LonghornSilicon/lambda/chip/README.md

# chip/ — cross-block integration (belongs to no single block)

Cross-block work that isn't owned by any one block: the integration cosim and the full-chip PDK
assembly. Mirrors (optionally) to `lambda-chip`.

```
chip/
├── verif/       Cross-block cosim: tb_chip_cosim.sv + vendored block RTL (blocks/) + Makefile + real-Qwen vectors.
│               Run: make -C chip/verif cosim
└── pdk/gf180/   Full-chip GF180MCU padring assembly (imported from the former chipathon-lambda-acu; honest skeleton).
```

## verif/ — the cross-block cosim
First cross-block integration of the live block RTLs on one shared attention tile, with a real INT8
P·V MAC so the attention output flows all the way through. Curated copy of the former `architecture`
repo's cross-block cosim (now sourced here). See `verif/README.md` for what runs.

**Note (drift):** `verif/blocks/` currently **vendors copies** of the KVE/ACU/TIU block RTL (the
copy-drift the monorepo is meant to eliminate). Once `src/blocks/kve/rtl`, `src/blocks/tiu/rtl`, and `acu/rtl` are the
single source of truth, re-point the `verif/Makefile` include paths at them and drop the vendored
copies. ACU is now imported (`acu/{mate,vecu,precision_controller}/rtl` exist as canonical RTL), so
this re-point is **unblocked** — pending, not held.
