LonghornSilicon/lambda/src/blocks/tiu/docs/findings/h2o-analysis.md

# H2O Accumulated-Mass Token Retention on Qwen2 — Analysis Phase

**Status:** Complete — algorithm validated, proceed to RTL.
**Date:** 2026-07-17.
**One-line:** H2O (keep recent window + top heavy-hitters by accumulated post-softmax
attention mass) holds HellaSwag acc_norm within −0.006 of a full KV cache down to a
25% cache budget on Qwen2-0.5B; it degrades sharply below ~15%.

---

## Motivation

Block 3 (Token Importance Unit) must keep the KV cache within a fixed on-die budget
as context grows. That requires a per-token importance signal and an eviction policy.
The ACU sparsity study already settled the *signal*: **post-softmax attention mass
predicts token importance (r≈0.99); pre-softmax proxies do not (r≈0)**. H2O is the
canonical policy built on that signal, and is what we're carrying into silicon.

## Method

`analysis/h2o_analysis.py` registers a custom Qwen2 attention (transformers 5.x
`AttentionInterface`) that, per (layer, head):

1. Computes the causal post-softmax attention matrix `A` (scores in fp32 — fp16
   QK^T over D=128 overflows to NaN).
2. Accumulates each key's received mass `acc[i,j] = Σ_{q≤i} A[q,j]` (`A.cumsum`).
3. For a fixed cache budget of C tokens (fraction of sequence length), once the
   sequence exceeds C, retains a recent window of L = C/2 tokens plus the top
   (C − L) heavy hitters by `acc`, and masks out the rest, renormalizing `A`.

Evaluated on HellaSwag (n=500) across budget fractions 1.0 → 0.10.
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
