LonghornSilicon/lambda/research/apa-precision-policy/analysis/figures/accuracy_vs_baselines.png

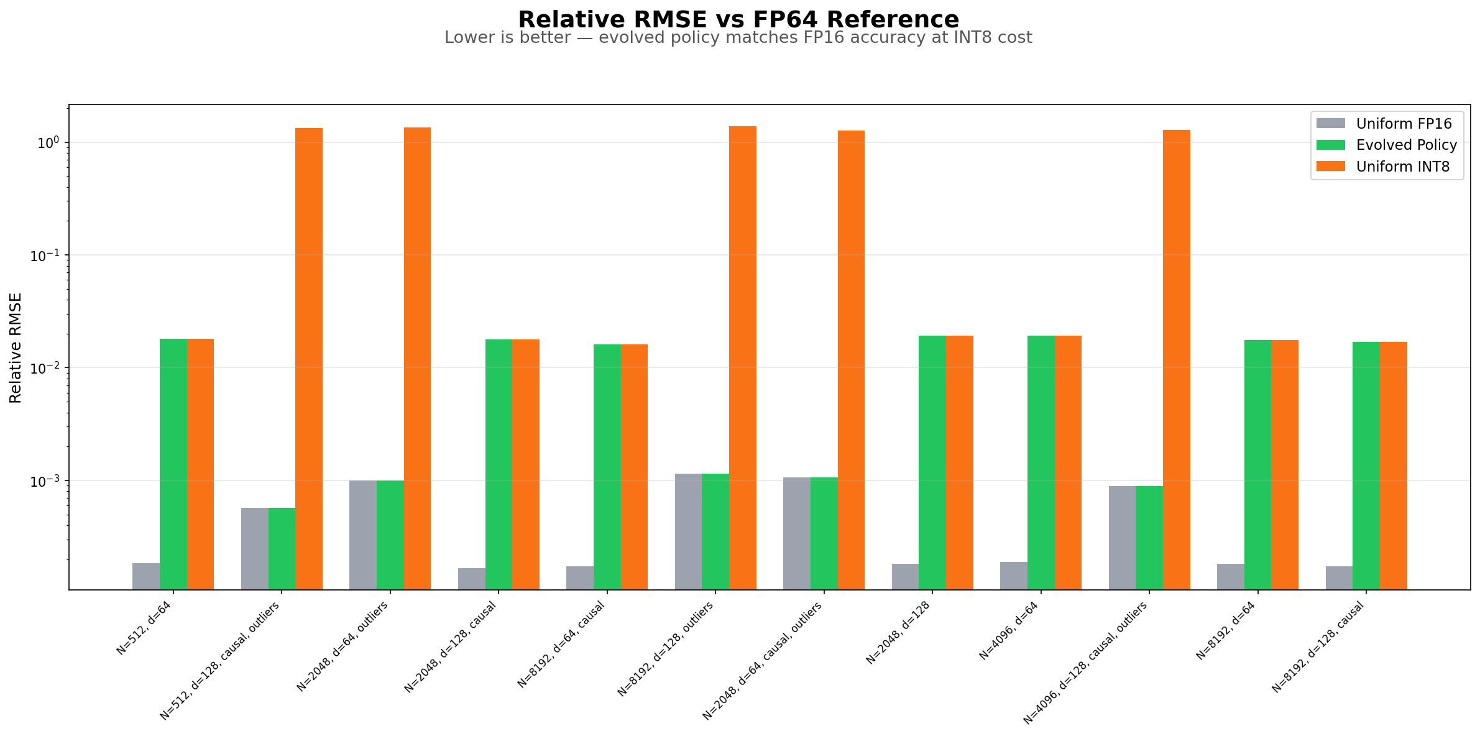
research/apa-precision-policy/analysis/figures/accuracy_vs_baselines.png
