LonghornSilicon/lambda/research/apa-precision-policy/analysis/figures/block_size_sweep.png

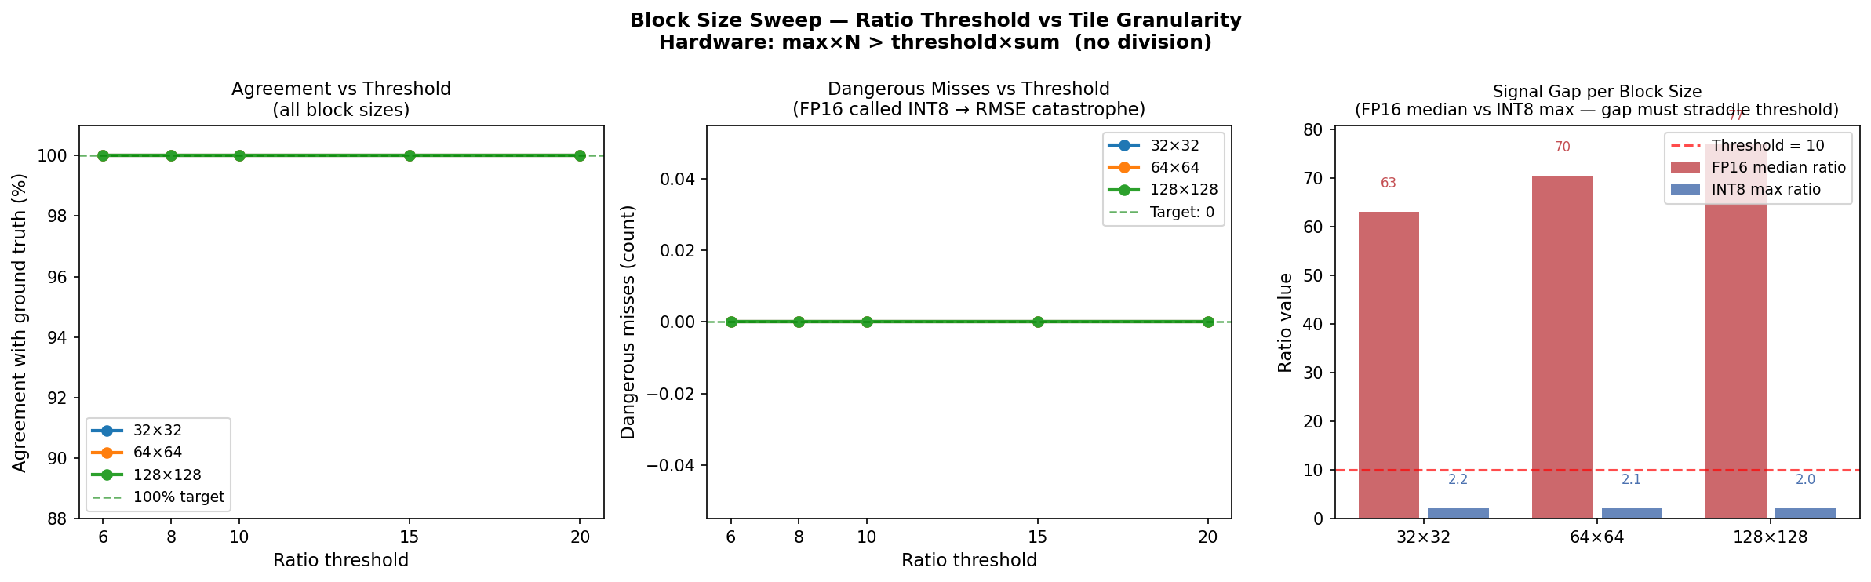
research/apa-precision-policy/analysis/figures/block_size_sweep.png
