LonghornSilicon/lambda/research/apa-precision-policy/analysis/figures/compression_summary.png

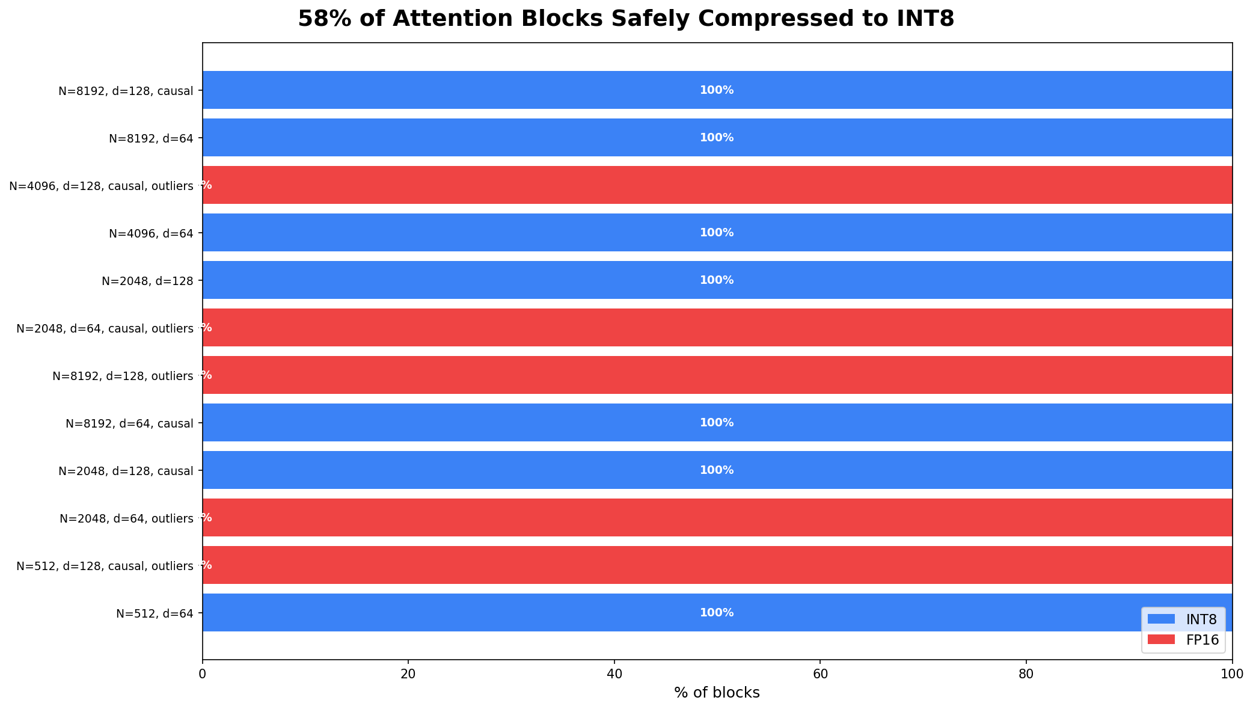
research/apa-precision-policy/analysis/figures/compression_summary.png
