LonghornSilicon/lambda/research/apa-precision-policy/analysis/figures/deep_layer_comparison.png

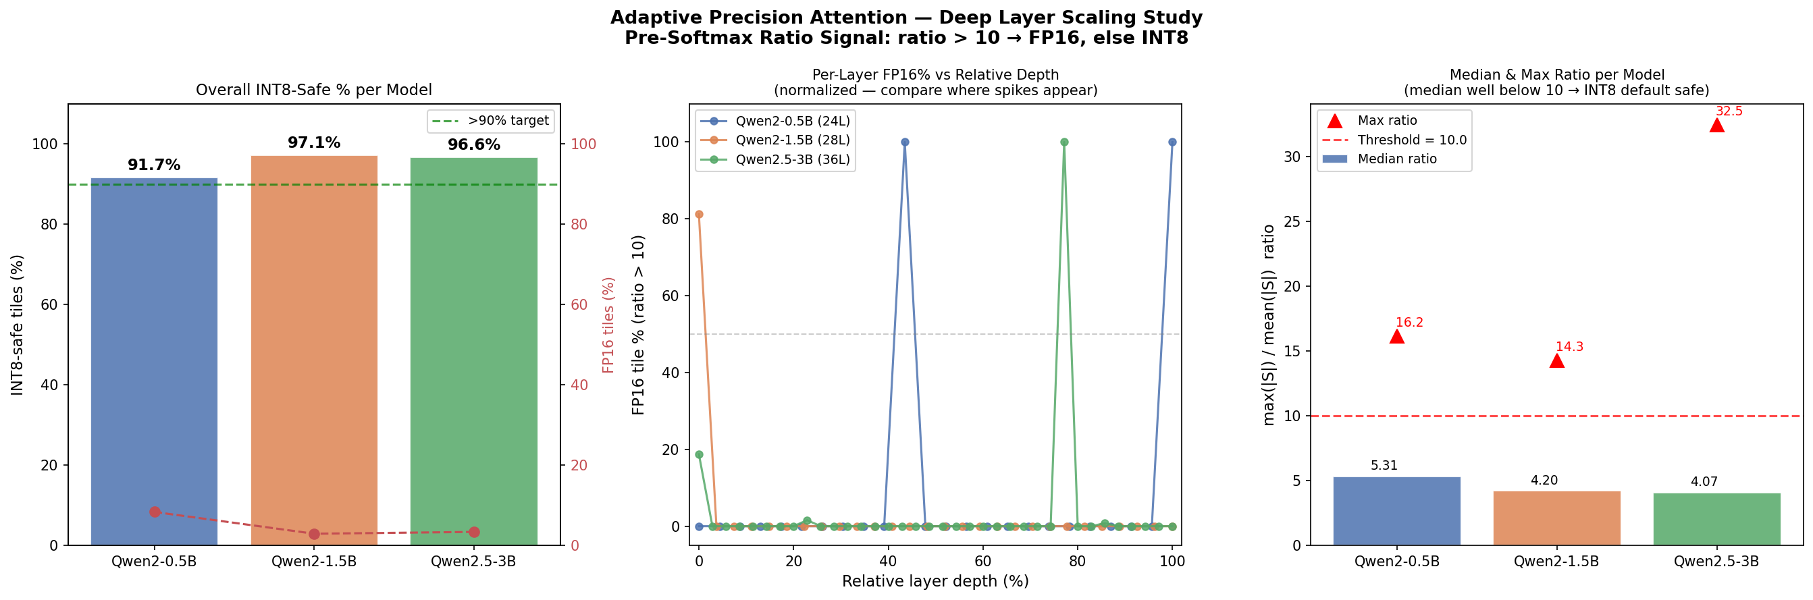
research/apa-precision-policy/analysis/figures/deep_layer_comparison.png
