LonghornSilicon/lambda/research/apa-precision-policy/analysis/figures/entropy_distribution.png

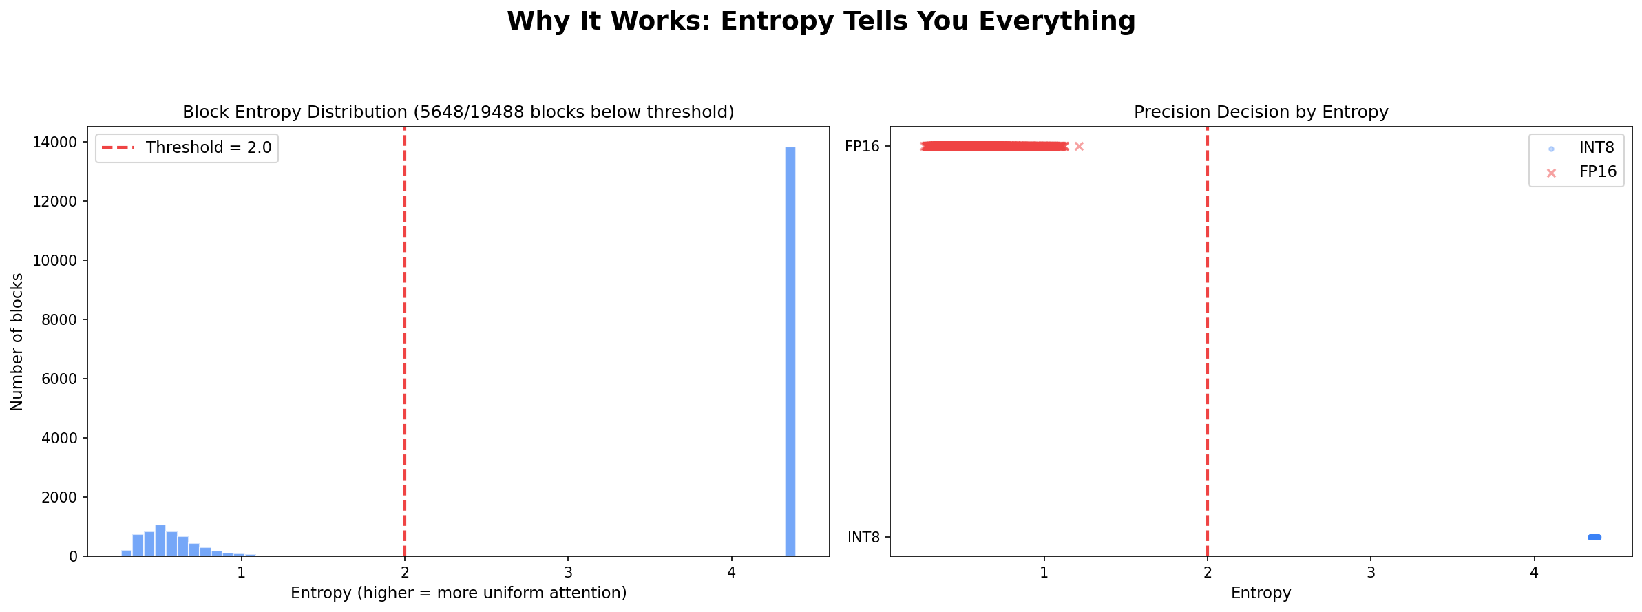
research/apa-precision-policy/analysis/figures/entropy_distribution.png
