LonghornSilicon/lambda/research/apa-precision-policy/analysis/figures/fixed_point_sim.png

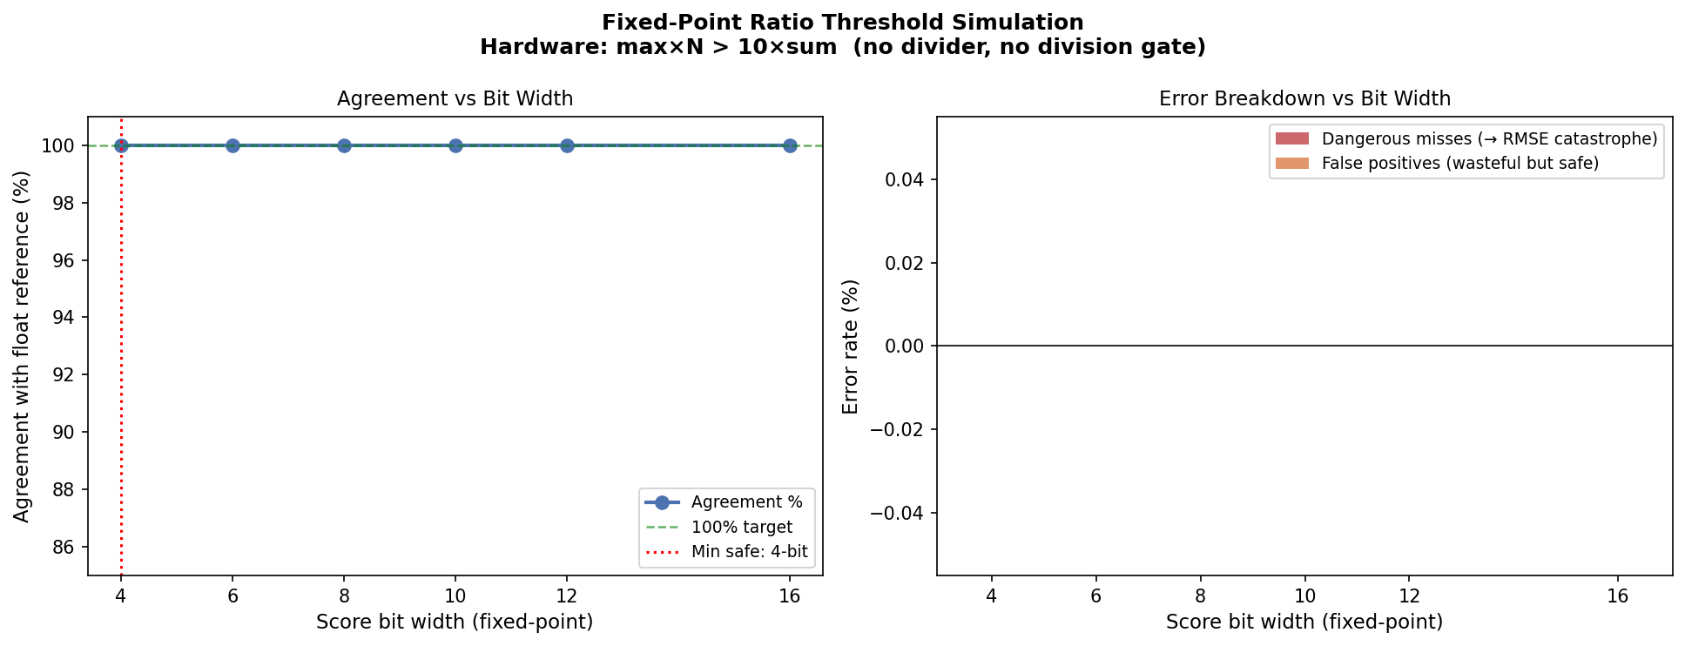
research/apa-precision-policy/analysis/figures/fixed_point_sim.png
