LonghornSilicon/lambda/research/apa-precision-policy/analysis/figures/precision_heatmaps.png

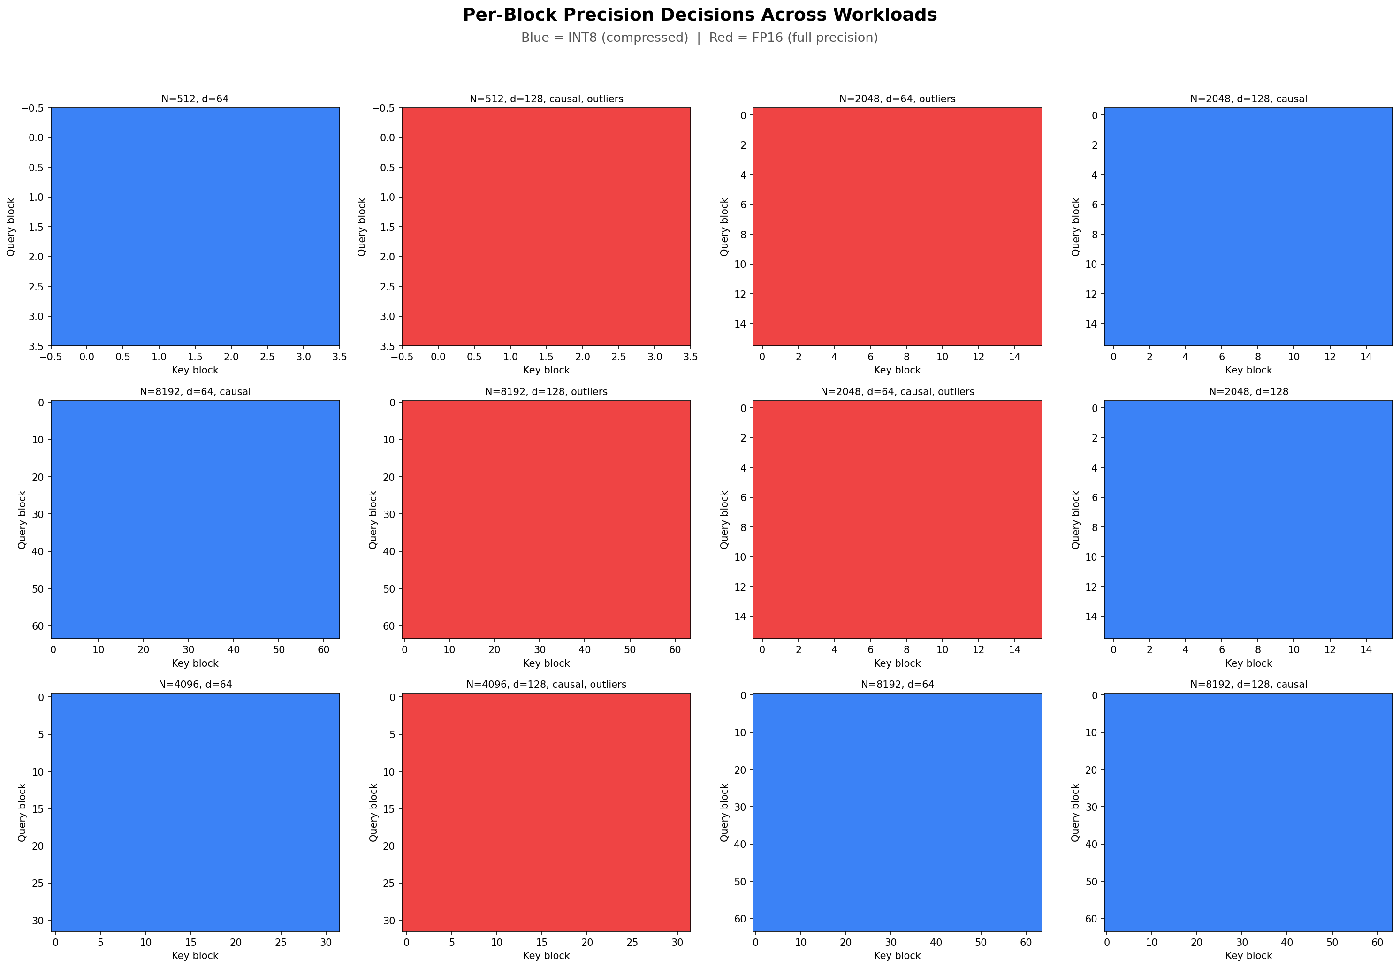
research/apa-precision-policy/analysis/figures/precision_heatmaps.png
