LonghornSilicon/lambda/research/apa-precision-policy/analysis/figures/real_llm_v2.png

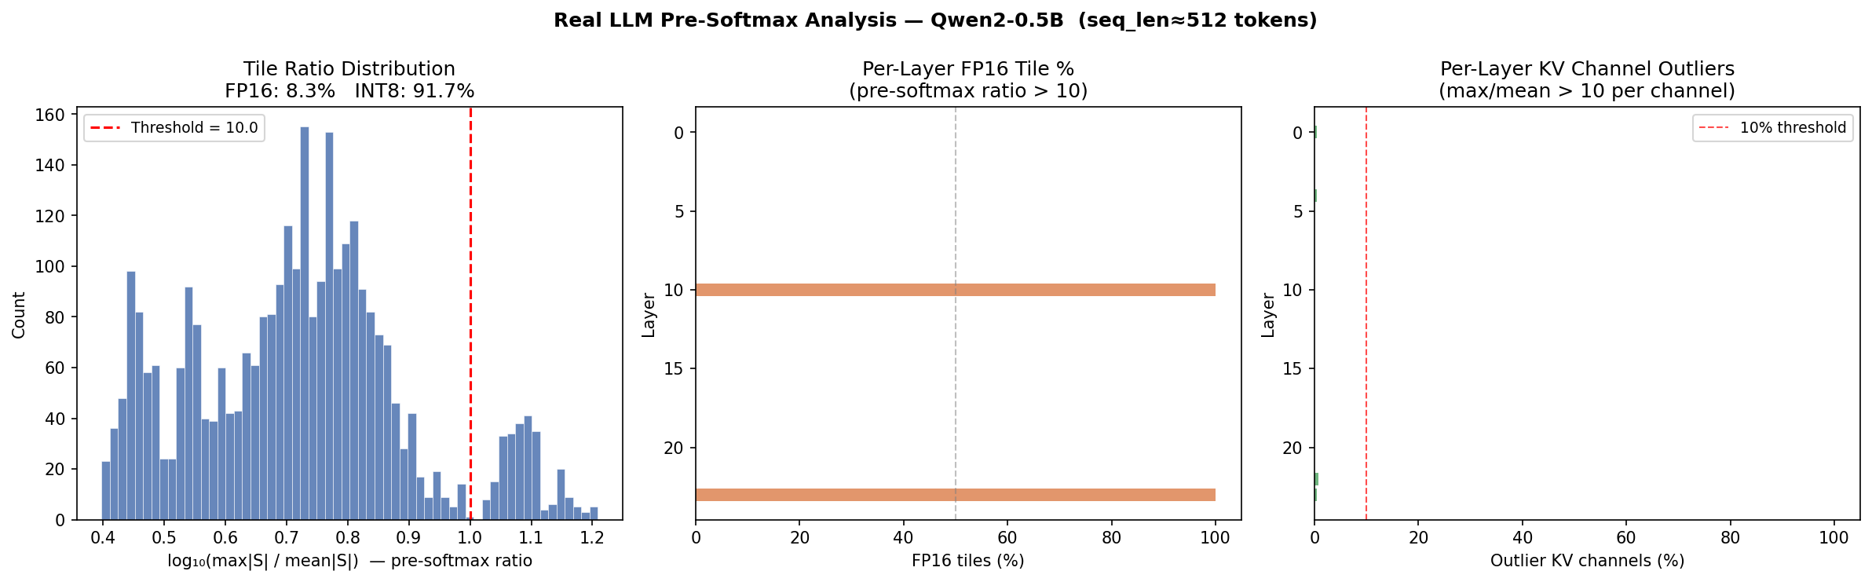
research/apa-precision-policy/analysis/figures/real_llm_v2.png
