LonghornSilicon/lambda/research/apa-precision-policy/analysis/figures/rtl_area_vs_bitwidth.png

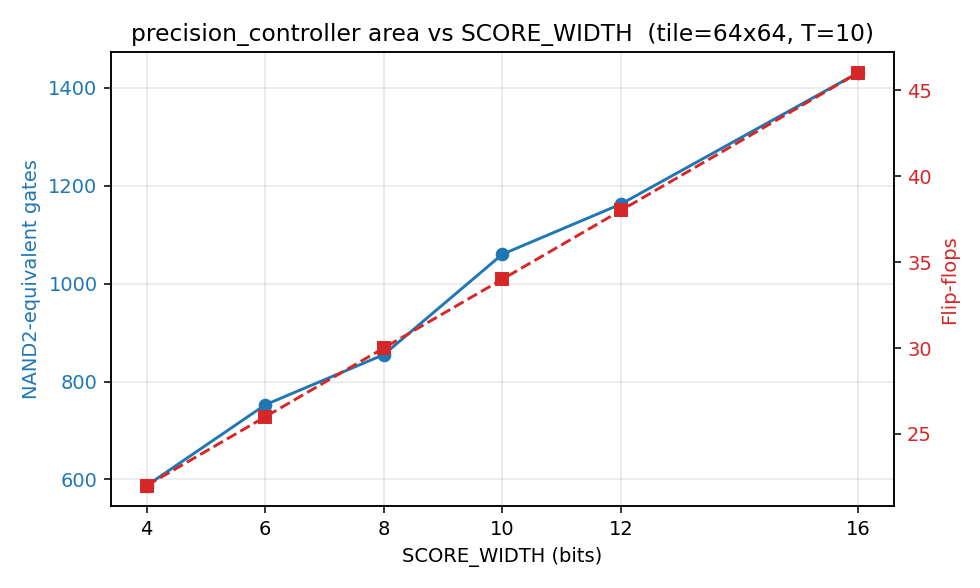
research/apa-precision-policy/analysis/figures/rtl_area_vs_bitwidth.png
