LonghornSilicon/lambda/research/apa-precision-policy/analysis/figures/seq_length_scaling.png

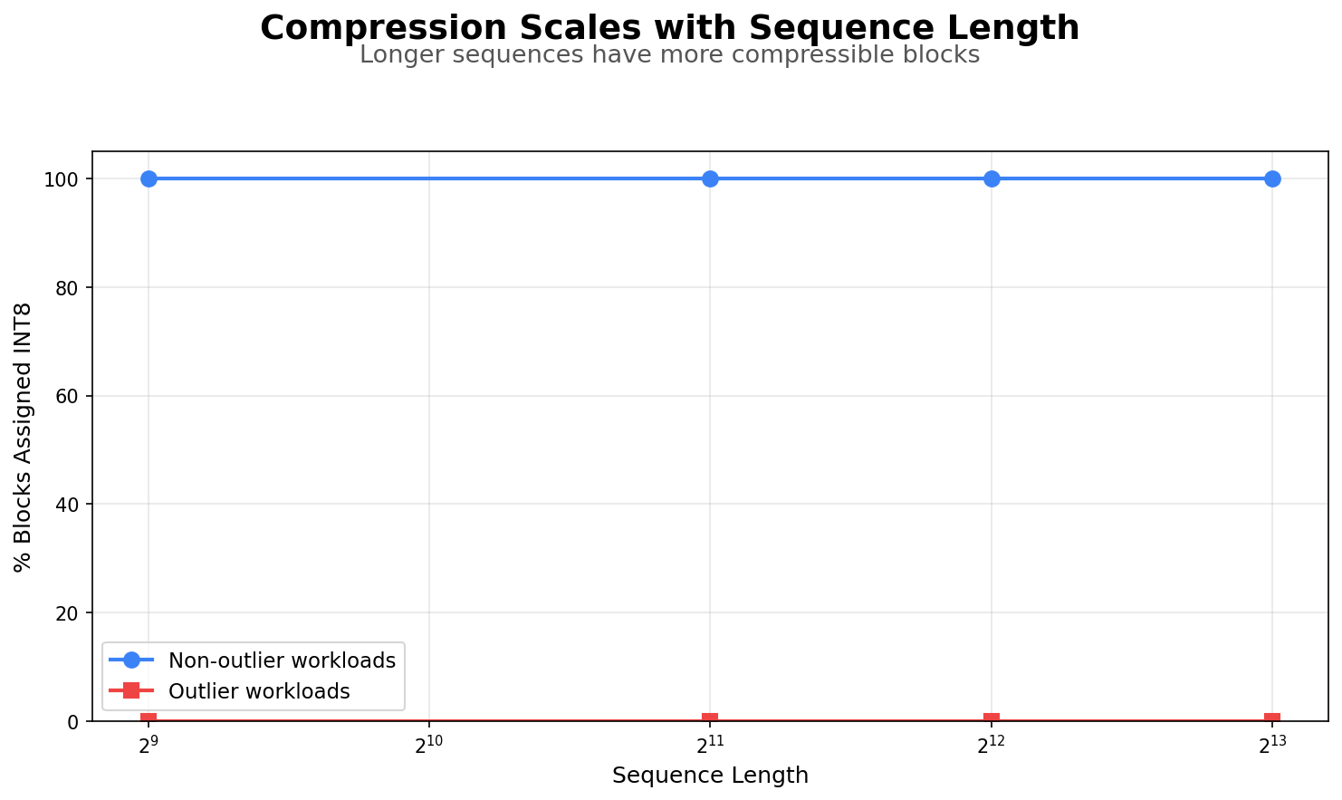
research/apa-precision-policy/analysis/figures/seq_length_scaling.png
