LonghornSilicon/lambda/research/apa-precision-policy/analysis/figures/phi2_validation.png

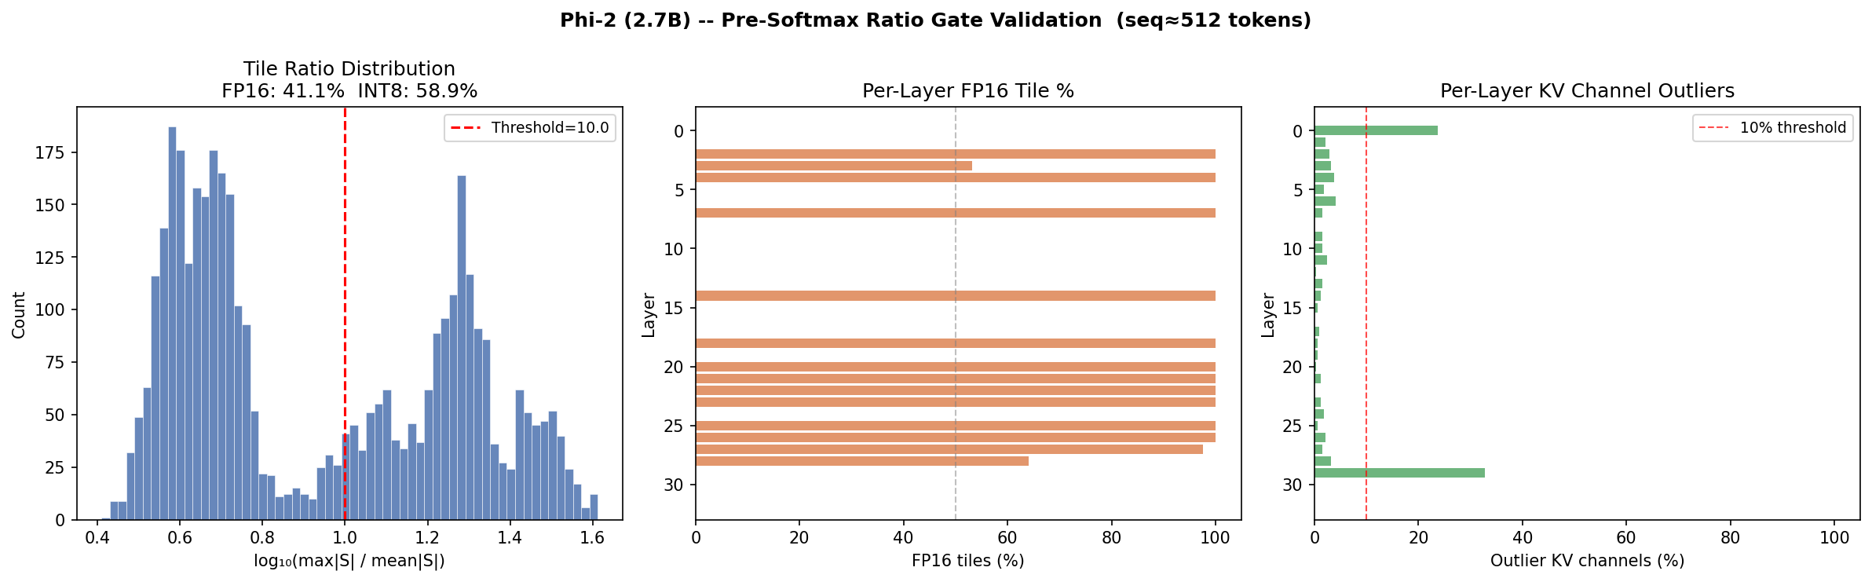
research/apa-precision-policy/analysis/figures/phi2_validation.png
