LonghornSilicon/lambda/research/apa-precision-policy/analysis/figures/real_llm_validation.png

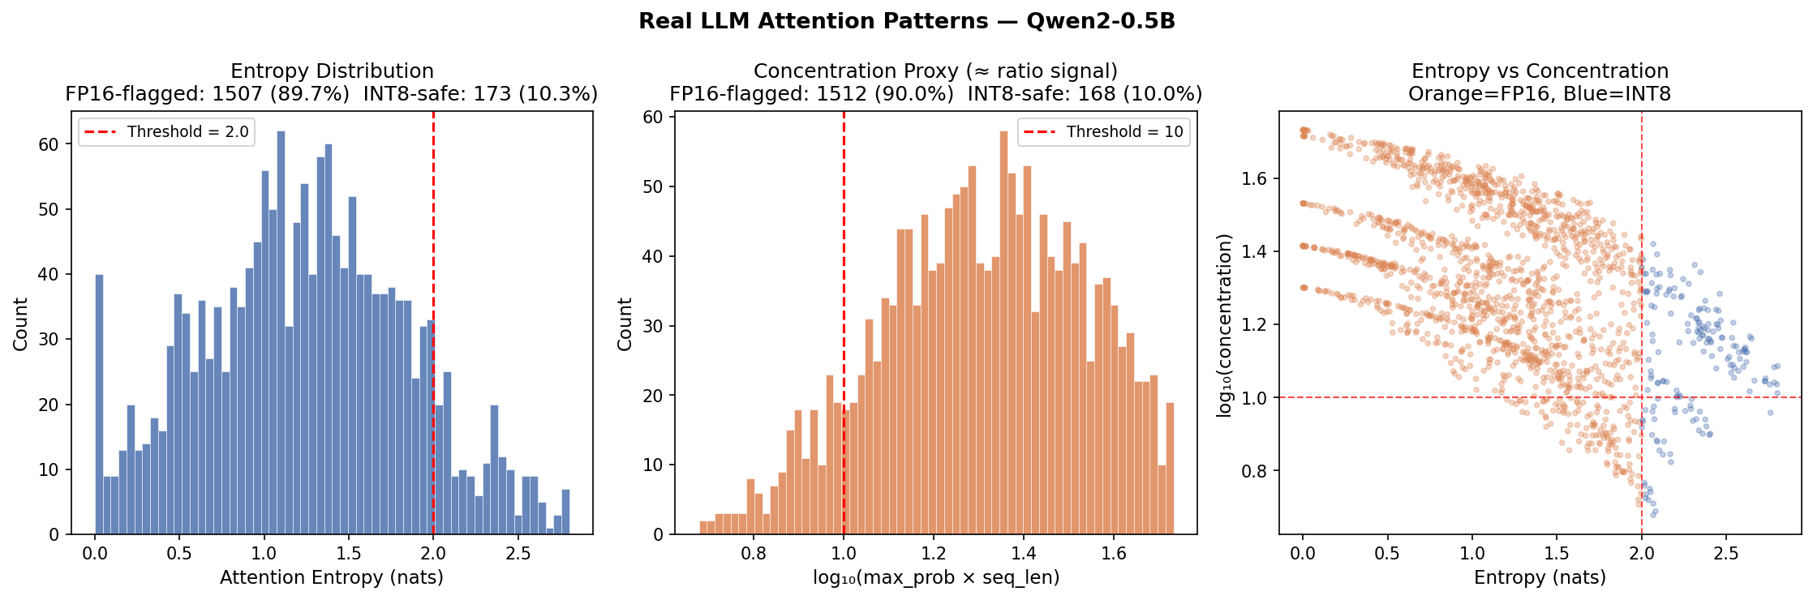
research/apa-precision-policy/analysis/figures/real_llm_validation.png
