LonghornSilicon/lambda/src/blocks/acu/mate/pdk/asap7/orfs/asap7/mate_pv_fp16/results_asap7/mate_pv_fp16_asap7_layout.webp

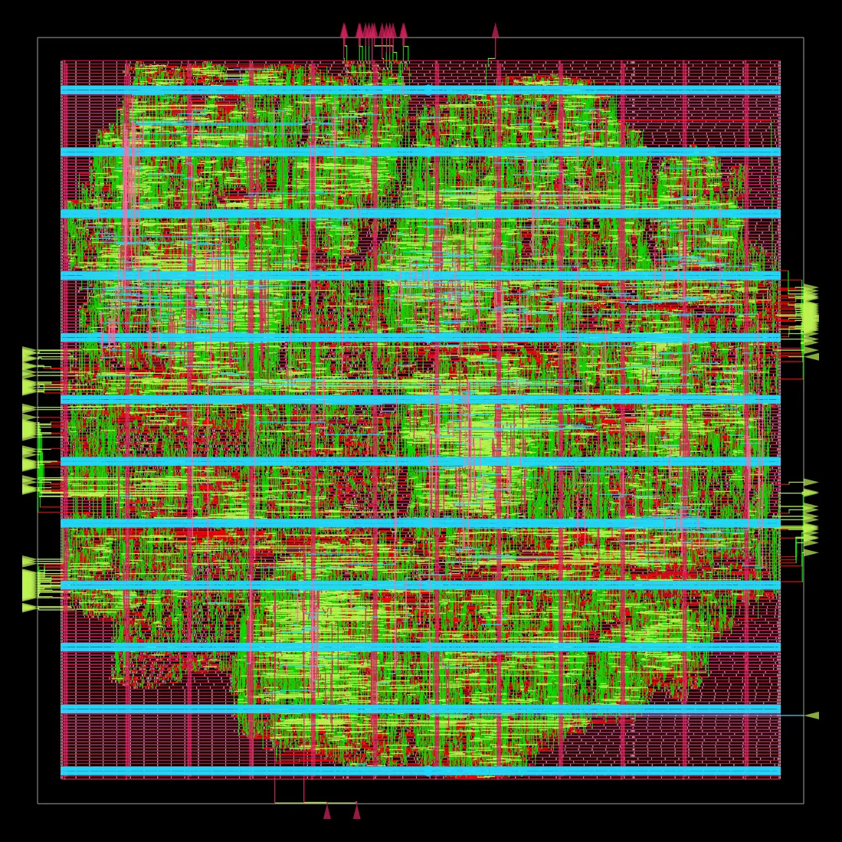
src/blocks/acu/mate/pdk/asap7/orfs/asap7/mate_pv_fp16/results_asap7/mate_pv_fp16_asap7_layout.webp
