LonghornSilicon/lambda/src/blocks/acu/mate/pdk/sky130/openlane/mate_pv/results/mate_pv.png

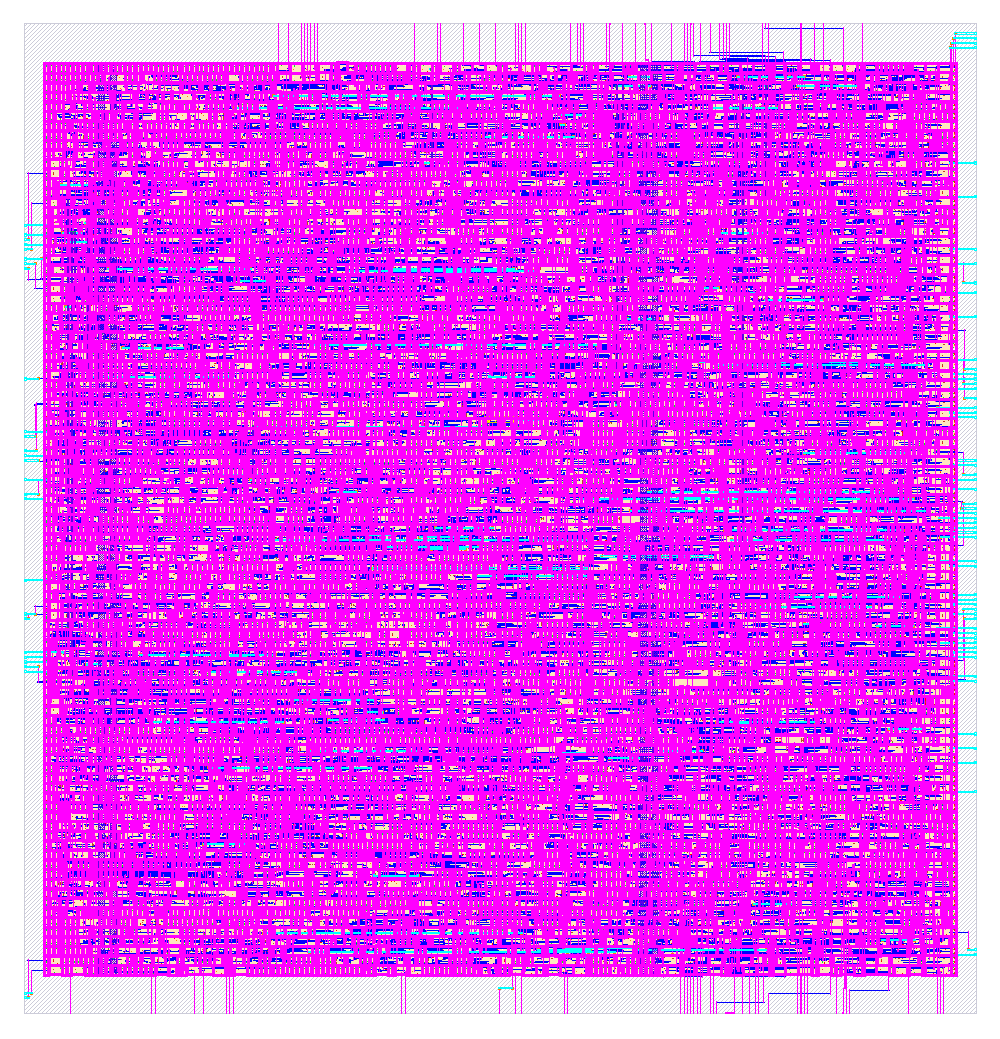
src/blocks/acu/mate/pdk/sky130/openlane/mate_pv/results/mate_pv.png
