LonghornSilicon/lambda/src/blocks/acu/mate/pdk/sky130/openlane/mate_pv_fp16/results/mate_pv_fp16.png

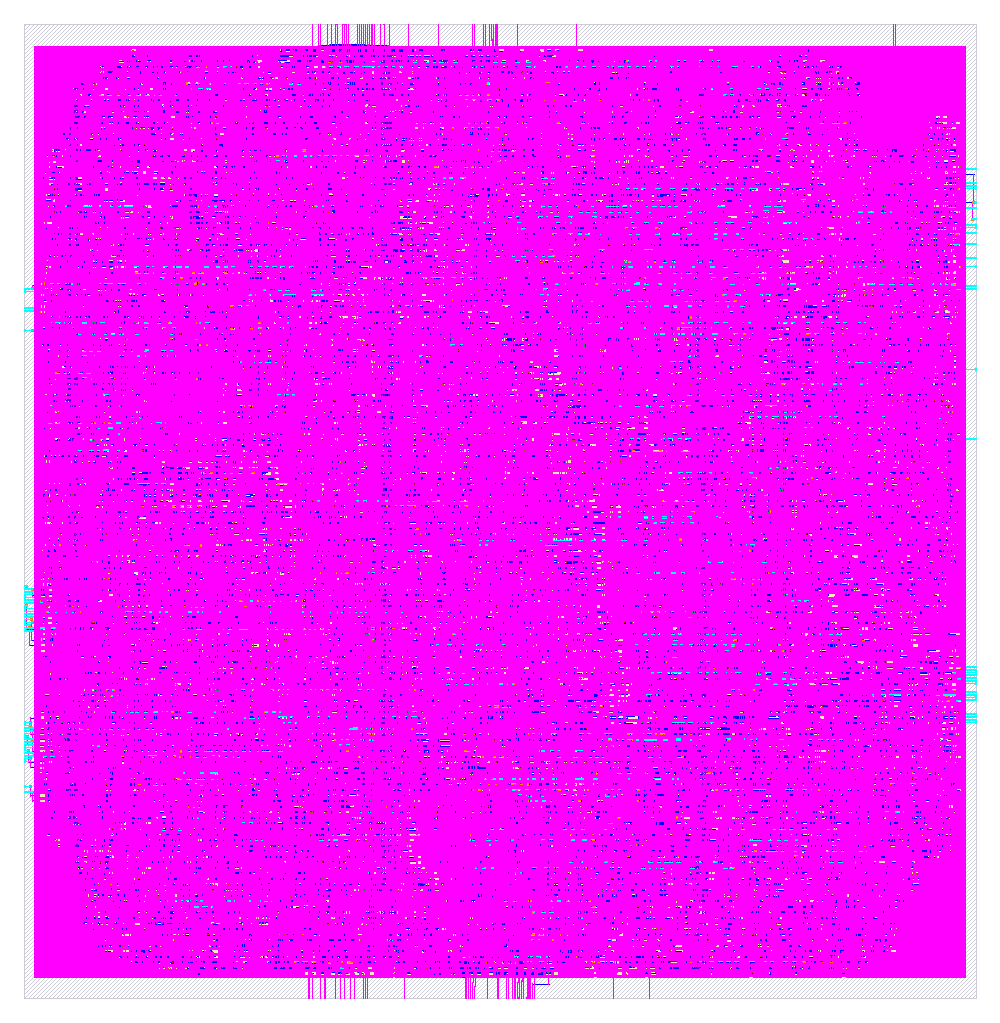
src/blocks/acu/mate/pdk/sky130/openlane/mate_pv_fp16/results/mate_pv_fp16.png
