LonghornSilicon/lambda/src/blocks/acu/mate/pdk/sky130/openlane/mate_qkt/results/mate_qkt.png

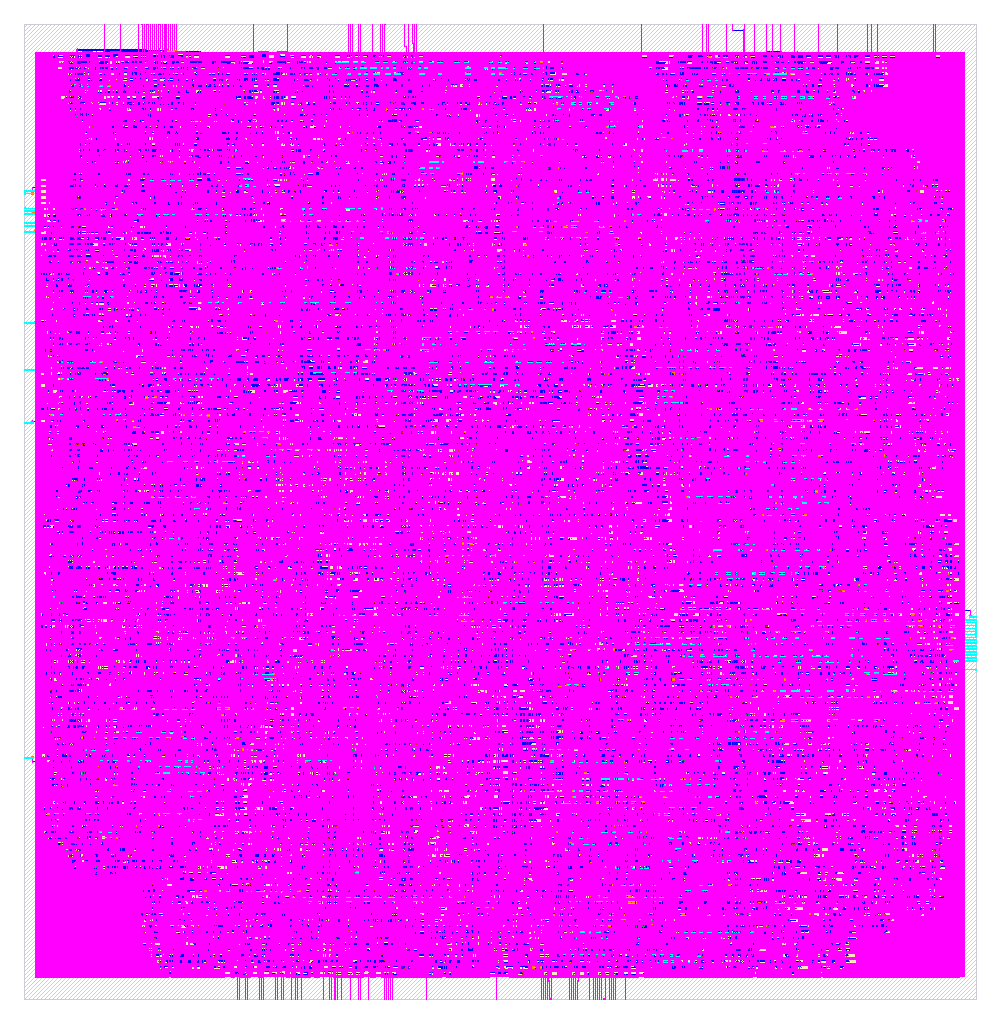
src/blocks/acu/mate/pdk/sky130/openlane/mate_qkt/results/mate_qkt.png
