LonghornSilicon/lambda/src/blocks/acu/precision_controller/pdk/asap7/orfs/asap7/precision_controller/results_asap7/precision_controller_asap7_layout.webp

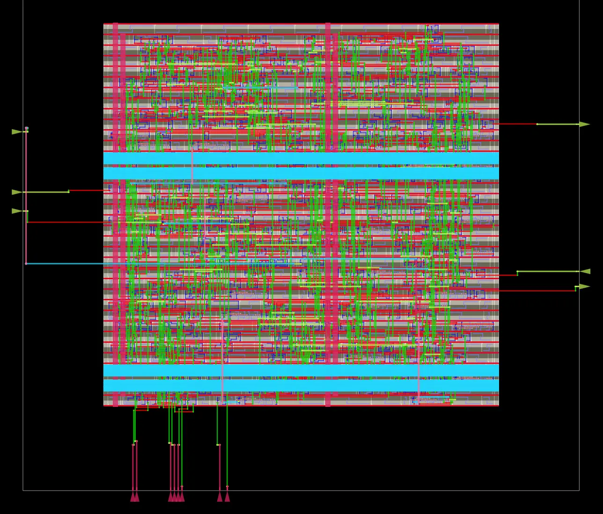
src/blocks/acu/precision_controller/pdk/asap7/orfs/asap7/precision_controller/results_asap7/precision_controller_asap7_layout.webp
