LonghornSilicon/lambda/src/blocks/acu/precision_controller/pdk/sky130/openlane/precision_controller/results/precision_controller.png

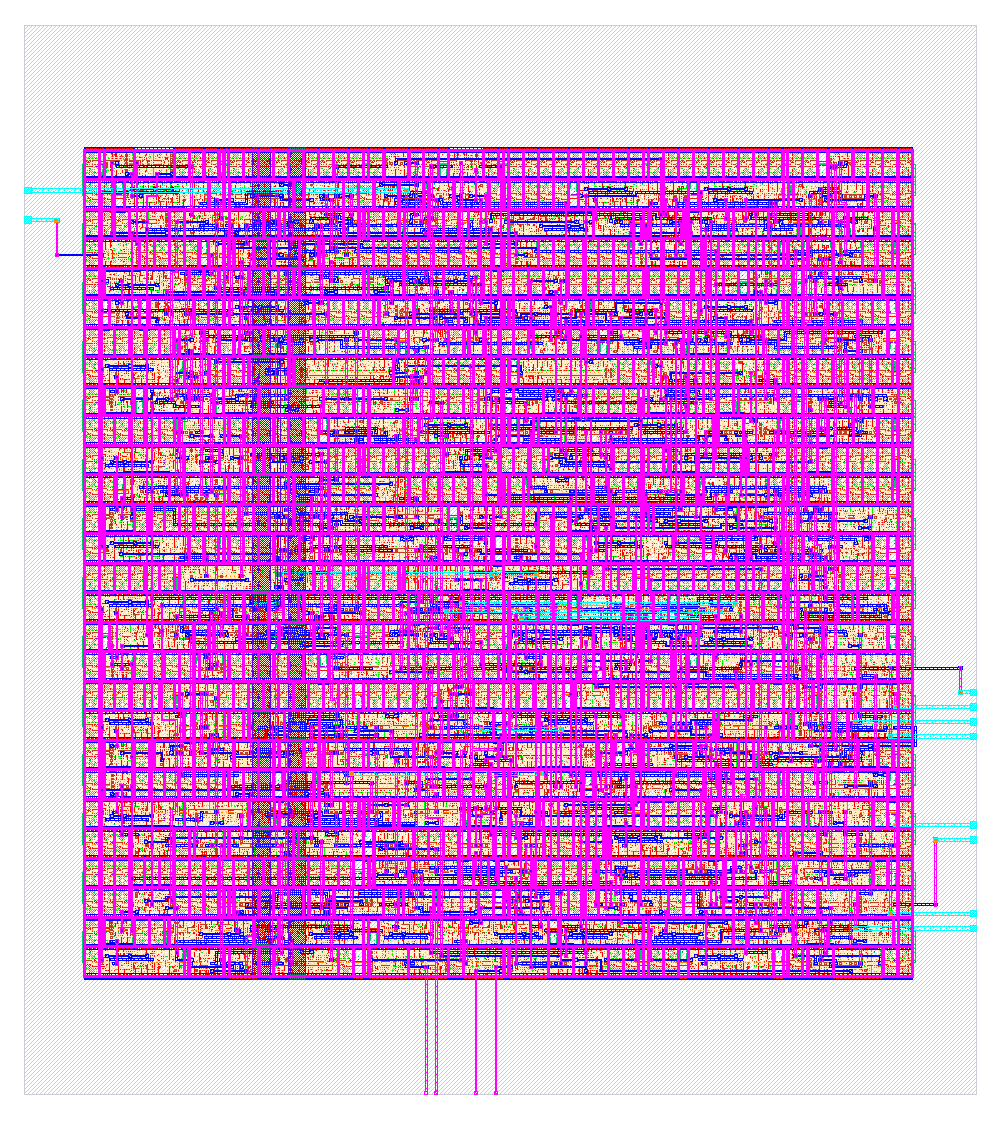
src/blocks/acu/precision_controller/pdk/sky130/openlane/precision_controller/results/precision_controller.png
