LonghornSilicon/lambda/src/blocks/acu/vecu/pdk/gf180/librelane/results/rmsnorm/rmsnorm_layout.png

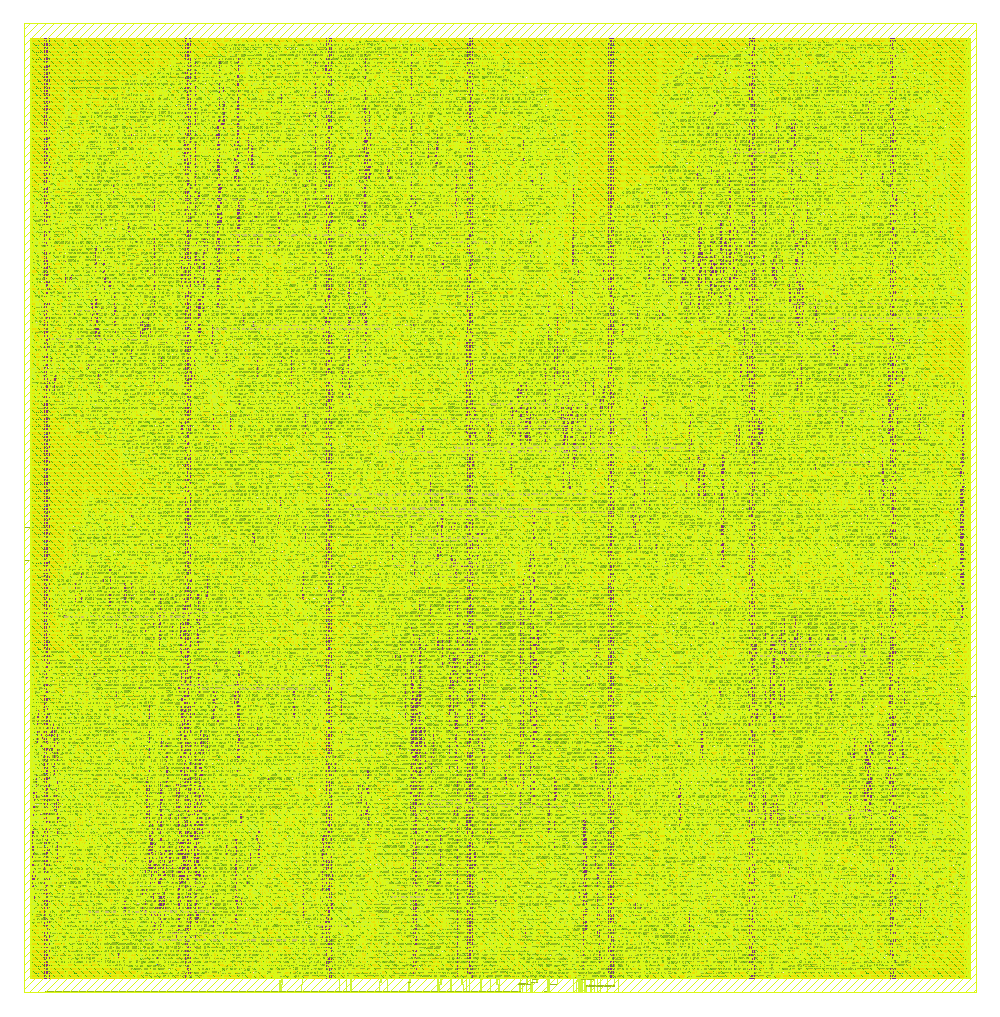
src/blocks/acu/vecu/pdk/gf180/librelane/results/rmsnorm/rmsnorm_layout.png
