LonghornSilicon/lambda/src/blocks/acu/vecu/pdk/gf180/librelane/results/rope/rope_layout.png

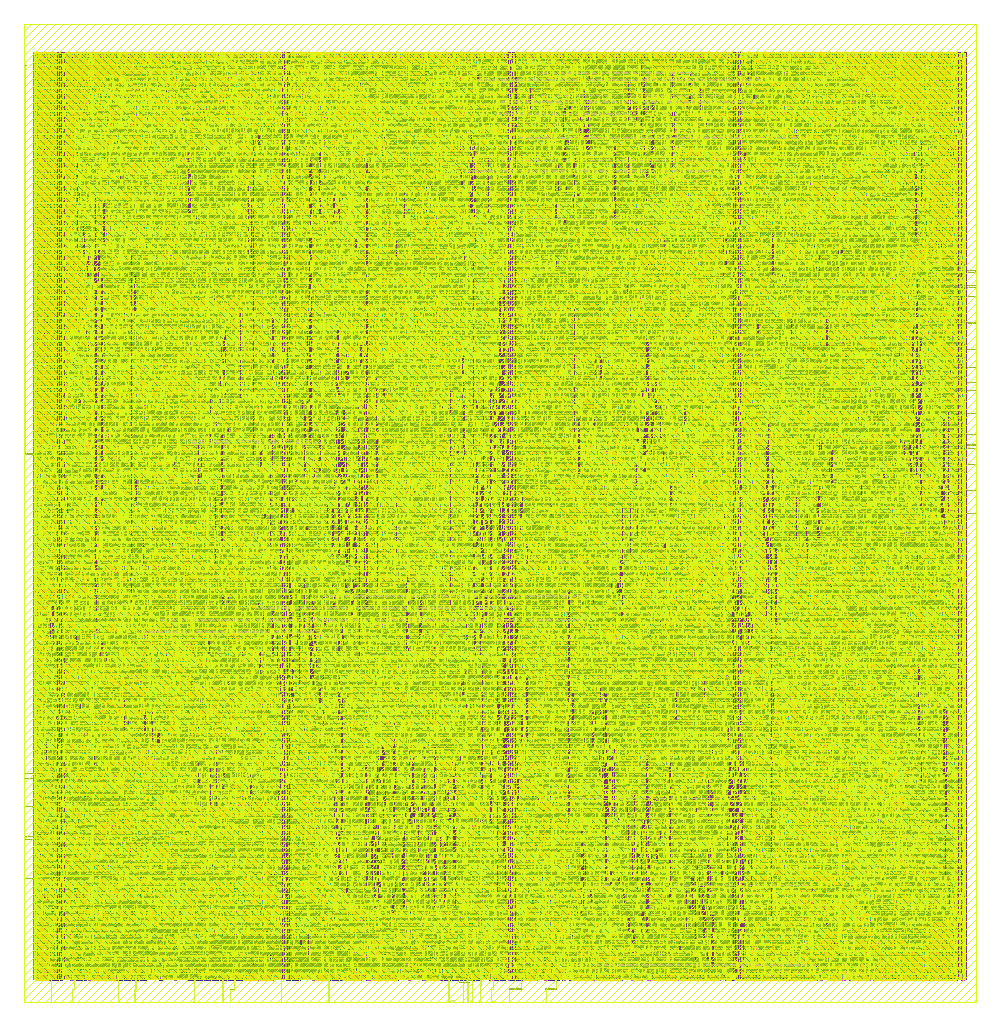
src/blocks/acu/vecu/pdk/gf180/librelane/results/rope/rope_layout.png
