LonghornSilicon/lambda/src/blocks/acu/vecu/pdk/sky130/openlane/rope/results/rope_layout.png

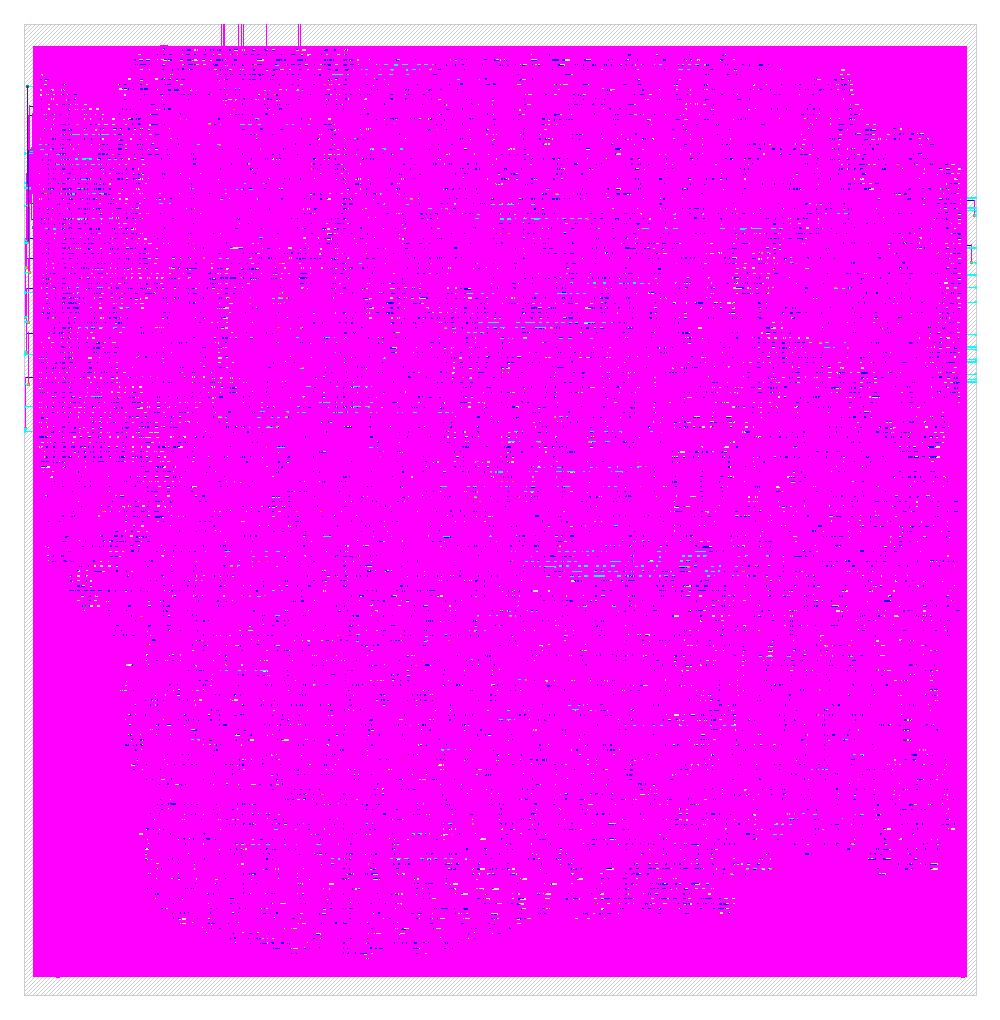
src/blocks/acu/vecu/pdk/sky130/openlane/rope/results/rope_layout.png
