LonghornSilicon/lambda/src/blocks/acu/vecu/pdk/sky130/openlane/vecu_softmax/results/vecu_softmax.png

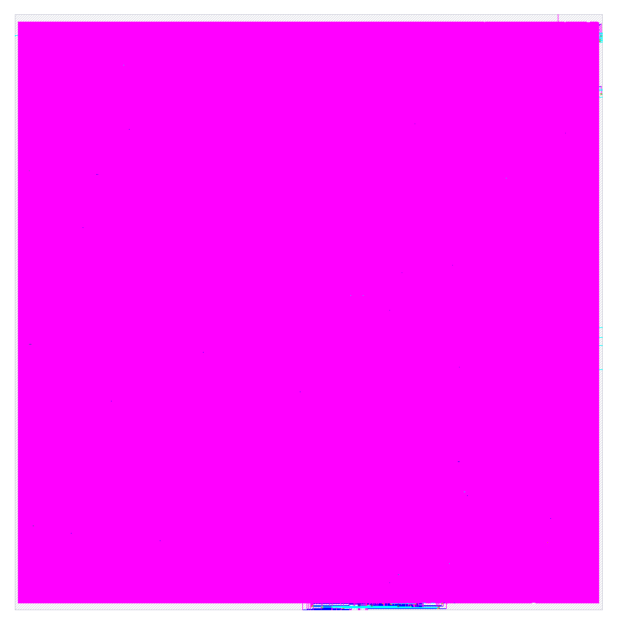
src/blocks/acu/vecu/pdk/sky130/openlane/vecu_softmax/results/vecu_softmax.png
