LonghornSilicon/lambda/src/blocks/tiu/pdk/sky130/openlane/token_importance_unit/results/layout.png

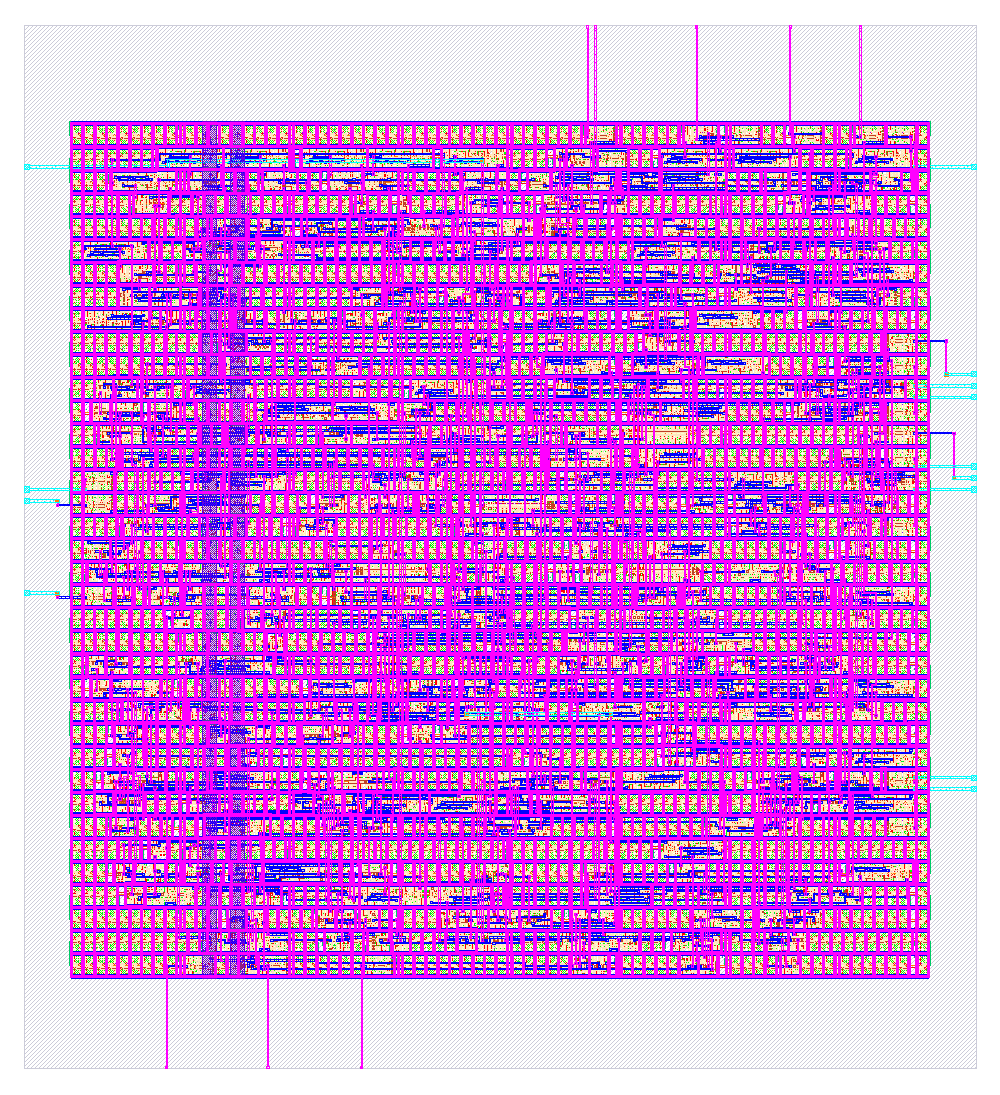
src/blocks/tiu/pdk/sky130/openlane/token_importance_unit/results/layout.png
