LonghornSilicon/lambda/chip/pdk/gf180/librelane/config_fullchip.yaml

# config_fullchip.yaml — Lambda ACU full-chip integration into the Chipathon
# 2026 GF180MCU workshop padring (fork: Mauricio-xx/chipathon-2026-gf180mcu-padring).
#
# This is the fork's librelane/config.yaml with the Lambda ACU dropped in as the
# core. It is meant to REPLACE the fork's librelane/config.yaml for the workshop
# slot (`SLOT=workshop`). scripts/submit.sh copies our RTL into <fork>/src/ and
# this config alongside, then runs the fork's `librelane` target.
#
# FLOW CHOICE — FLAT core synthesis (see chip/pdk/gf180/SUBMISSION.md §6).
#   lambda_acu (our decode-attention core) is synthesized FLAT inside the padring
#   Chip flow: every compute block (mate_qkt / mate_pv / mate_pv_fp16 /
#   vecu_softmax / precision_controller / token_importance_unit) plus the KVE
#   value path is synthesizable RTL and is elaborated at the EXACT parameters
#   lambda_acu instantiates (Dh=16, L=8). We deliberately do NOT place the
#   per-block hardened macros here: they were hardened at PROXY parameters
#   (mate_pv/mate_pv_fp16 N=4, token_importance_unit N_SLOTS=4, precision_controller
#   defaults) that do NOT match lambda_acu's instantiation sizes (N=16 / N_SLOTS=8 /
#   BLOCK 2x4), so a hard macro cannot be dropped in as-is. The per-block macro
#   GDS/LEF (kve/tiu/acu .../runs/) stand as standalone GF180 closure proof; the
#   full chip uses flat synthesis so each block lands at the right size.
#
#   The ONLY reason the flat flow ever failed was the behavioral KVE value-path
#   (`cq_value_path_wht` / `wht_inverse_out`) using SystemVerilog `real`. This
#   config uses the SYNTHESIZABLE lowering (`*_syn`, bit-exact vs the behavioral
#   oracle — see src/blocks/kve/rtl/tb/tb_wht_pathb_syn.sv), so yosys no longer aborts.

meta:
  version: 3
  flow: Chip

DESIGN_NAME: chip_top

# Better SystemVerilog elaboration (packages, structs, the ACU generate blocks).
USE_SLANG: true
SLANG_ARGUMENTS: ['--keep-hierarchy']

# Keep FULL hierarchy through synthesis AND into the netlist. Two reasons:
#  1. The flat fp16 decode datapath makes yosys' SAT resource-sharing (SHARE) pass
#     pathologically slow when flattened up front (never converges);
#     `SYNTH_HIERARCHY_MODE: keep` synthesizes per-module so SHARE stays bounded.
#  2. `flatten`/`deferred_flatten` rename or strip the padring's generate-loop pad
#     instances (dvdd_pads[i].pad, ...), which breaks OpenROAD's power global-
#     connect ("add_global_connections failed for dvdd_pads[0].pad/DVDD") and the
#     manual placement of the id/logo macros. `keep` preserves every instance path,
#     so the padring power connections resolve. Placement is still flat.
SYNTH_HIERARCHY_MODE: keep

# Re-assert the slot's SLOT_WORKSHOP (this config is loaded after the slot yaml
# and would otherwise clobber its VERILOG_DEFINES) and select the synthesizable
# KVE value-path lowering in lambda_acu (see lambda_acu.sv `LAMBDA_SYN_KVE`).
VERILOG_DEFINES: ["SLOT_WORKSHOP", "LAMBDA_SYN_KVE"]

VERILOG_FILES:
# --- padring + our core override ---
- dir::../src/chip_top.sv          # fork's padring top (unchanged)
- dir::../src/chip_core.sv         # OUR workshop-slot core override (replaces fork's)
- dir::../src/lambda_acu.sv        # OUR decode-attention integration top + FSM
- dir::../src/spi_loader.sv        # OUR 4-wire SPI host loader
# --- ACU compute blocks (synthesizable, signed off standalone on Sky130+GF180) ---
- dir::../src/mate_qkt.sv
- dir::../src/mate_pv.sv
- dir::../src/mate_pv_fp16.sv
- dir::../src/vecu_softmax.sv
- dir::../src/precision_controller.sv
# --- TIU ---
- dir::../src/token_importance_unit.sv
# --- KVE value path: SYNTHESIZABLE lowering (no `real`), bit-exact vs behavioral ---
- dir::../src/wht_unit_syn.sv
- dir::../src/fp16_addsub_syn.sv
- dir::../src/cq_units_syn.sv
- dir::../src/cq_value_path_wht_syn.sv
- dir::../src/wht_inverse_out_syn.sv

PRIMARY_GDSII_STREAMOUT_TOOL: klayout

# SDC files (fork's)
PNR_SDC_FILE: dir::chip_top.sdc
SIGNOFF_SDC_FILE: dir::chip_top.sdc
FALLBACK_SDC: dir::chip_top.sdc

VDD_NETS:
- VDD
GND_NETS:
- VSS

IGNORE_DISCONNECTED_MODULES:
- gf180mcu_fd_io__bi_24t
- gf180mcu_ws_ip__id
- gf180mcu_ws_ip__logo

# Clock — the padring clk pad feeds the core clk. 40 ns (25 MHz) matches the
# fork; the ACU fp16 blocks are the critical paths and may need retiming (they
# closed standalone at 180-260 ns) — raise CLOCK_PERIOD if setup fails.
CLOCK_PORT: clk_PAD
CLOCK_NET: clk_pad/Y
CLOCK_PERIOD: 200

PL_RESIZER_HOLD_SLACK_MARGIN: 0.35
GRT_RESIZER_HOLD_SLACK_MARGIN: 0.3

# Core is large (fp16 decode datapath); start loose and tighten.
PL_TARGET_DENSITY_PCT: 35
GRT_ALLOW_CONGESTION: true

DRT_ANTENNA_REPAIR_ITERS: 10
DRT_ANTENNA_REPAIR_MARGIN: 10

# PDN — straps (fork's values)
PDN_VWIDTH: 5
PDN_HWIDTH: 5
PDN_VSPACING: 1
PDN_HSPACING: 1
PDN_VPITCH: 75
PDN_HPITCH: 75

PDN_CORE_RING: True
PDN_CORE_RING_VWIDTH: 25
PDN_CORE_RING_HWIDTH: 25
PDN_CORE_RING_CONNECT_TO_PADS: True
PDN_ENABLE_PINS: False
PDN_CORE_VERTICAL_LAYER: Metal2
PDN_CORE_HORIZONTAL_LAYER: Metal3

ERROR_ON_MAGIC_DRC: False

MAGIC_GDS_FLATGLOB:
- "*_CDNS_*"
- "*$$*"
- "M1_N*"
- "M1_P*"
- "M2_M1*"
- "M3_M2*"
- "nmos_5p0*"
- "nmos_1p2*"
- "pmos_5p0*"
- "pmos_1p2*"
- "via1_*"
- "ypass_gate*"
- "G_ring_*"
- "dcap_103*"
- "din_*"
- "mux821_*"
- "rdummy_*"
- "pmoscap_*"
- "xdec_*"
- "ypredec*"
- "xpredec*"
- "prexdec_*"
- "xdec8_*"
- "xdec16_*"
- "xdec32_*"
- "sa_*"

KLAYOUT_FILLER_OPTIONS:
  Metal2_ignore_active: true

MAGIC_EXT_UNIQUE: notopports

# DECORATIVE MACROS DROPPED for the Lambda full-chip build. The fork places two
# purely-decorative wafer.space IP macros (gf180mcu_ws_ip__id chip identifier +
# __logo; the fork's own chip_top.sv comments the logo "can be removed"). They are
# EMPTY, port-less instances with no functional connection. Under our fast
# `deferred_flatten` synthesis (needed so yosys' SHARE pass converges on the fp16
# datapath) the post-flatten opt_clean strips port-less cells, and a `(* keep *)`
# does not survive slang -> flatten, so OpenROAD's manual macro placement aborts
# ("No macro instance ... found"). Since they are cosmetic, submit.sh strips their
# two instantiations from chip_top.sv and we place NO user macros — the Lambda
# core is flat std-cell logic. (To restore them: use SYNTH_HIERARCHY_MODE flatten,
# but that makes SHARE non-converging on this design.)
MACROS: {}

PDN_MACRO_CONNECTIONS: []

FP_MACRO_HORIZONTAL_HALO: 10
FP_MACRO_VERTICAL_HALO: 10
PDN_HORIZONTAL_HALO: 5
PDN_VERTICAL_HALO: 5

PDN_CFG: dir::pdn_cfg.tcl
